Anuki16/gas-level-indicator/Product photo.jpeg

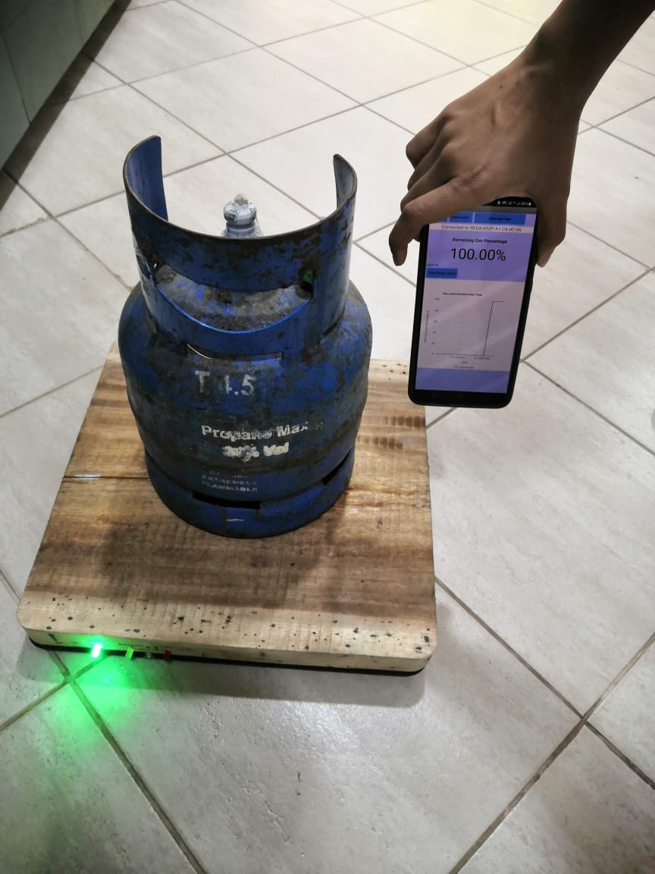
Product photo.jpeg
