Anuki16/gas-level-indicator/hx711 circuit.png

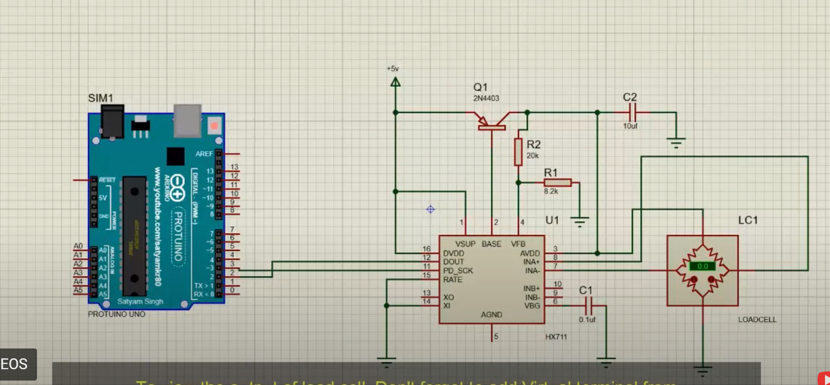
hx711 circuit.png
