Anuki16/gas-level-indicator/Design Project Presentation.pdf

# GasCheck Gas Level Indicator

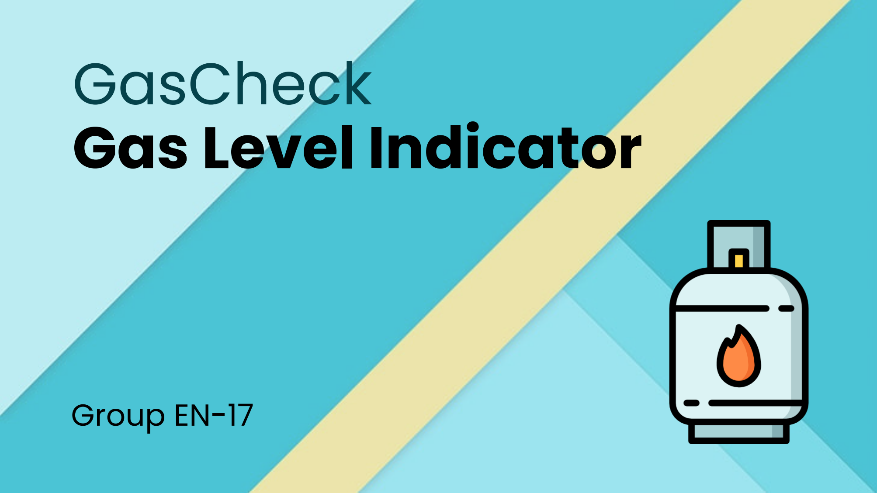
[picture p3: page 1]

## Group EN-17

In Sri Lankan households, LPG is the common fuel used for cooking.
In the prevailing economic crisis, it has become a difficulty to purchase gas in many households. Because of that, it has become a necessity to

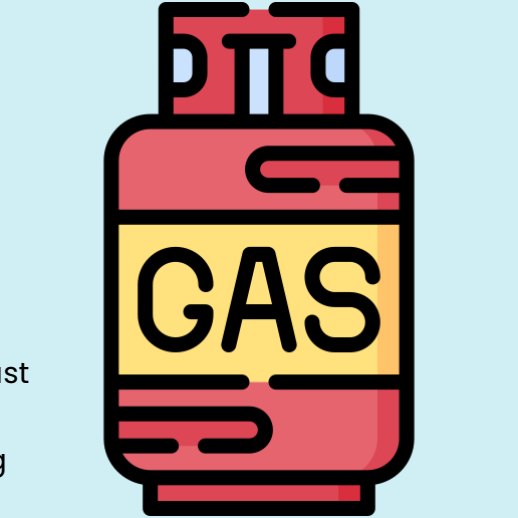
[picture p4: figure]

carefully manage the usage of gas and make it last longer.
As there is no method of measuring the remaining gas level precisely, the only current way of doing this is by guesswork.

# The Problem

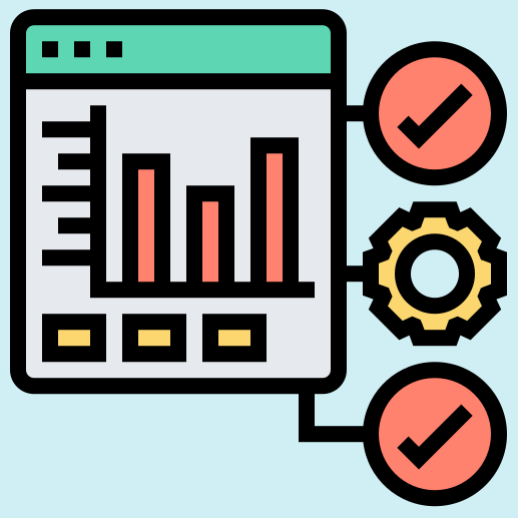
[picture p5: figure]

To help people conserve gas optimally, our idea was to design a method to measure the remaining gas level in the cylinder.

We conducted a survey to validate whether the problem we identified is worth handling and whether our solution is useful.

79 people responded and 76 were gas users.

# Problem Validation

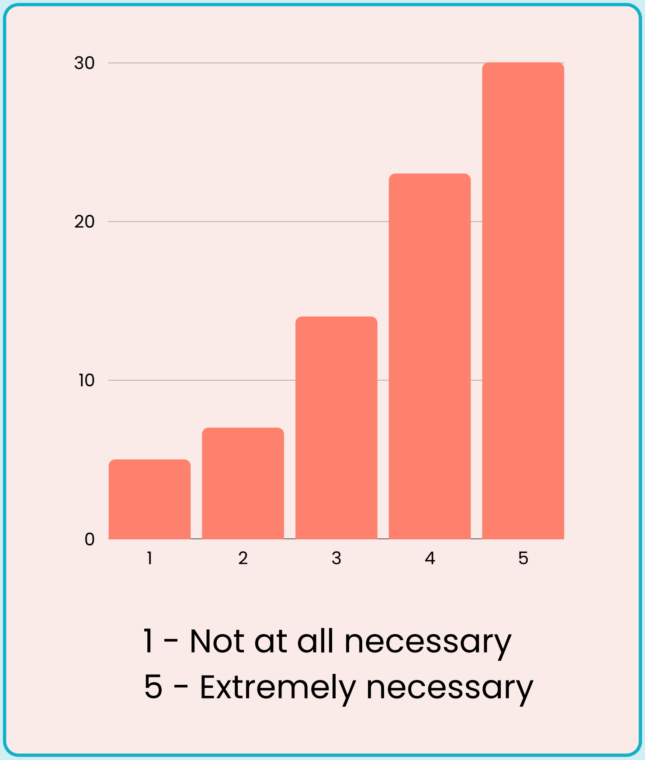
[picture p6: figure]
1 - Not at all necessary 5 - Extremely necessary

Gas conservation at home is extremely necessary for 38% of the respondents, and 84.6% considered it to be at least a moderate necessity.

# Necessity of gas conservation

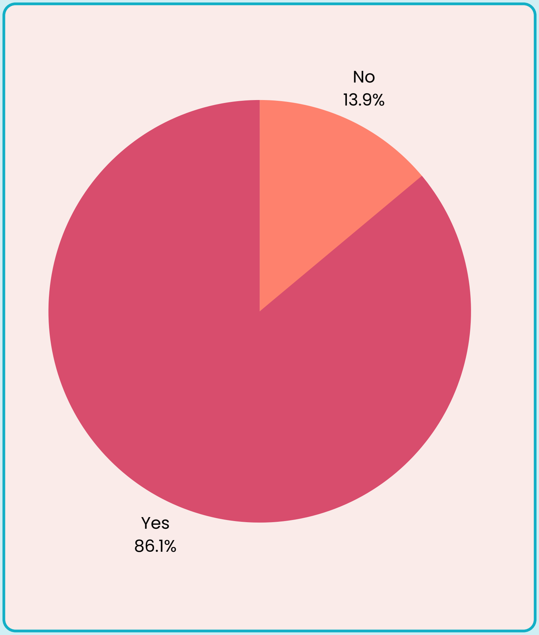
[picture p7: figure]
Yes 86.1%

86.1% of the respondents agreed that a method of checking the gas level will make it easier to conserve and manage gas usage in their households.

# Usefulness of the solution

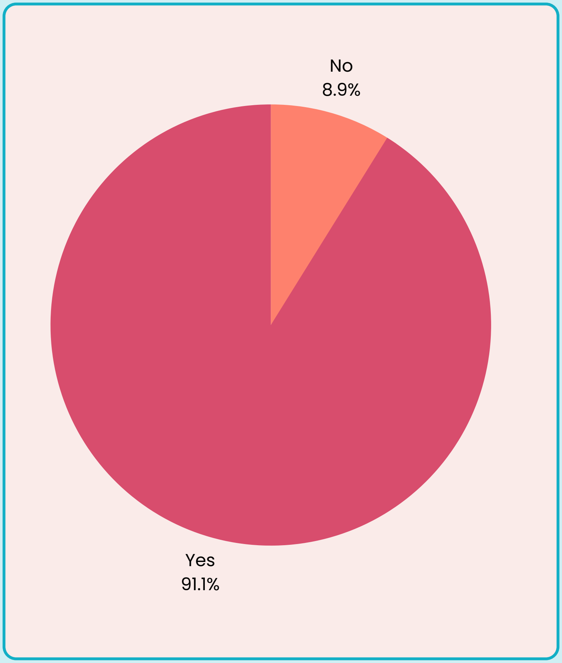
[picture p8: figure]

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
willin

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
h in

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
m in

a

n
a

p

p

e

alin

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
will b

e

b

e

n

e

ficial t

o

a
sig

nific

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
# s. Appeal of the product

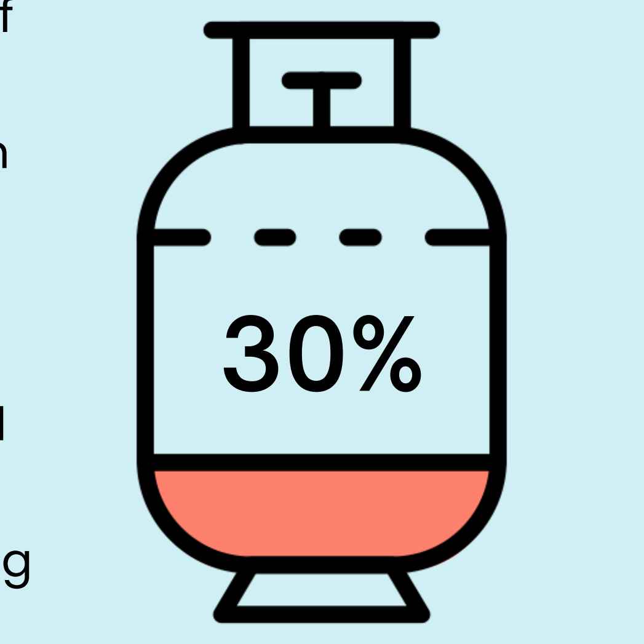
[picture p9: figure]

Consists of a weighing scale and a mobile application connected using Bluetooth
The cylinder is continuously kept on the scale
The mobile app will show the remaining gas percentage and other statistics about gas usage, and notify when the gas level is low
The scale lights up LEDs with different colors depending on the gas level
Compatible with all cylinder sizes used in households

A device which will be able to calculate the percentage of gas remaining in the cylinder by measuring its weight.

# Our product

Accuracy of gas percentage | 12.5kg : 1.6% 5kg : 4%
Power supply | 4 AA batteries
Power consumption | ~200 mW
Dimensions of the scale | 35 x 35 x 3 cm
Expected lifetime | 4 years
Warranty period | 1 year

# Technical Specifications

The measurements will be
updated in the app once per hour whenever the mobile
phone is within 10 meters of the scale.

The mobile app will be able to store data up to one year.

### Four half-bridge strain gauge load cells (50 kg capacity)

### HX711 load cell amplifier

### ATmega328P microcontroller

### HC-06 Bluetooth module

# Main Components

All these components are
commonly found at an affordable cost.

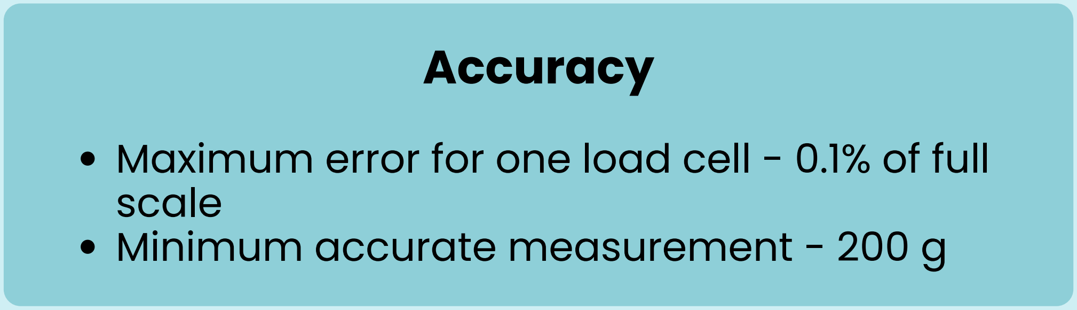
[picture p10: figure]
scale Minimum accurate measurement - 200 g; Accuracy

Maximum error for one load cell - 0.1% of full

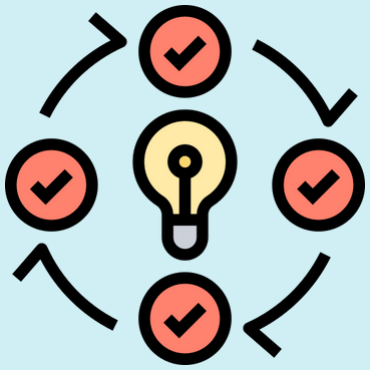
[picture p11: figure]

# Technical Feasibility

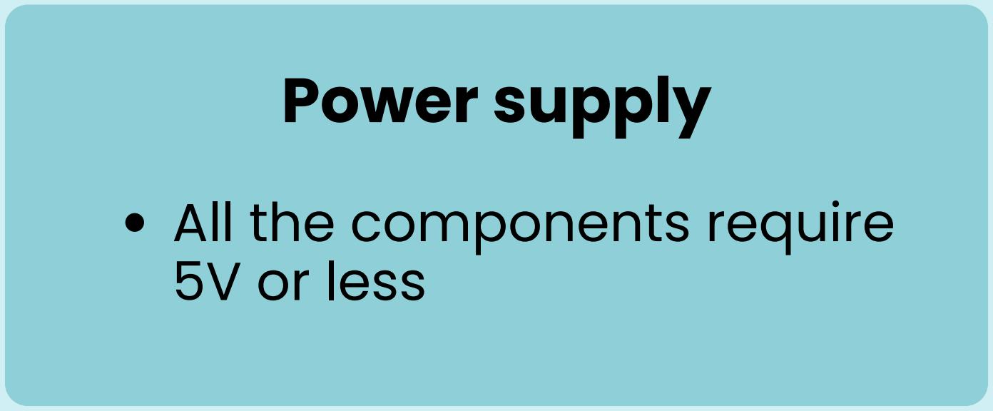
[picture p12: figure]
All the components require 5V or less; Power supply

# Technical Feasibility

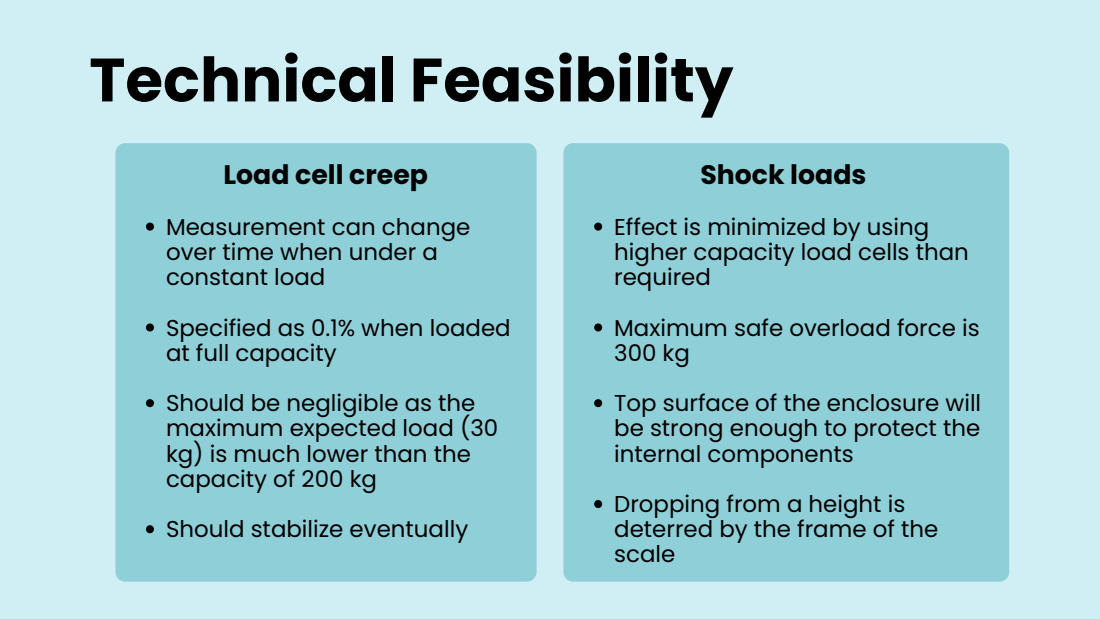
[picture p13: page 11]

Load cell creep
Measurement can change
over time when under a
constant load
Specified as 0.1% when loaded
at full capacity
Should be negligible as the
maximum expected load (30
kg) is much lower than the
capacity of 200 kg
Should stabilize eventually

Shock loads
Effect is minimized by using
higher capacity load cells than
required
Maximum safe overload force is
Top surface of the enclosure will
be strong enough to protect the
internal components
Dropping from a height is
deterred by the frame of the
scale

# Product Architecture

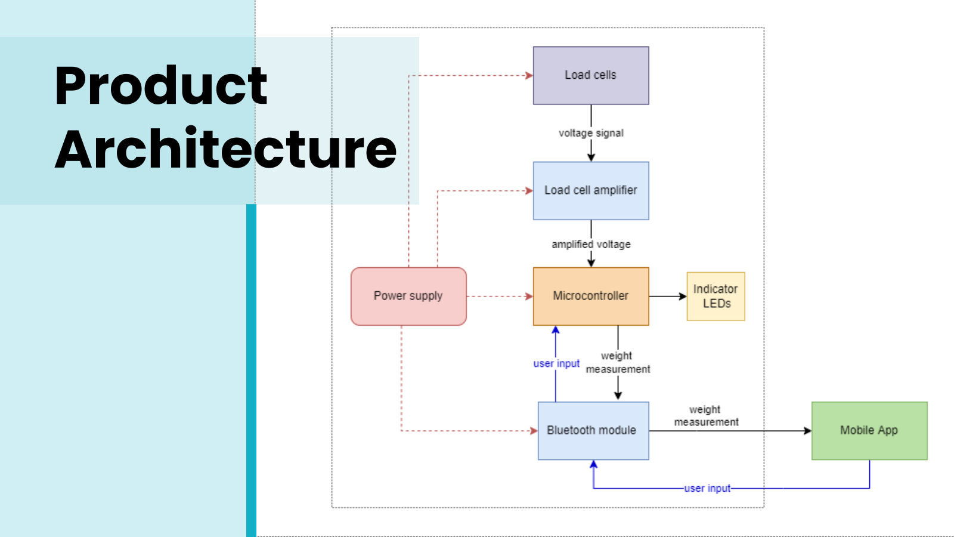
[picture p14: page 12]

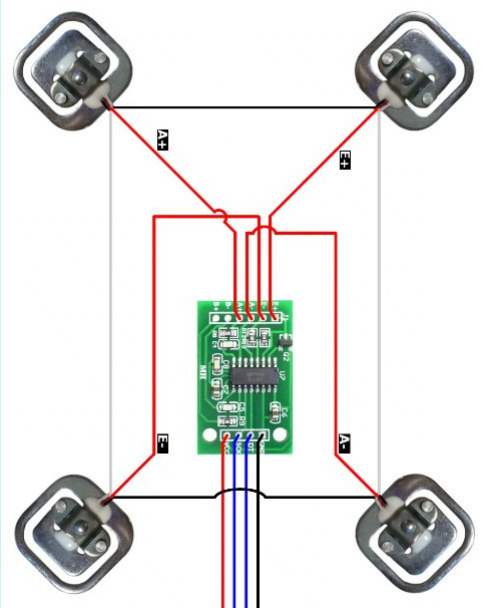
[picture p15: figure]

# Load cells

Change output voltage
proportional to the applied load Placed in the four corners and connected in a Wheatstone
bridge formation

# Load cell amplifier

Amplifies the voltage change detected from the load cells

# Microcontroller

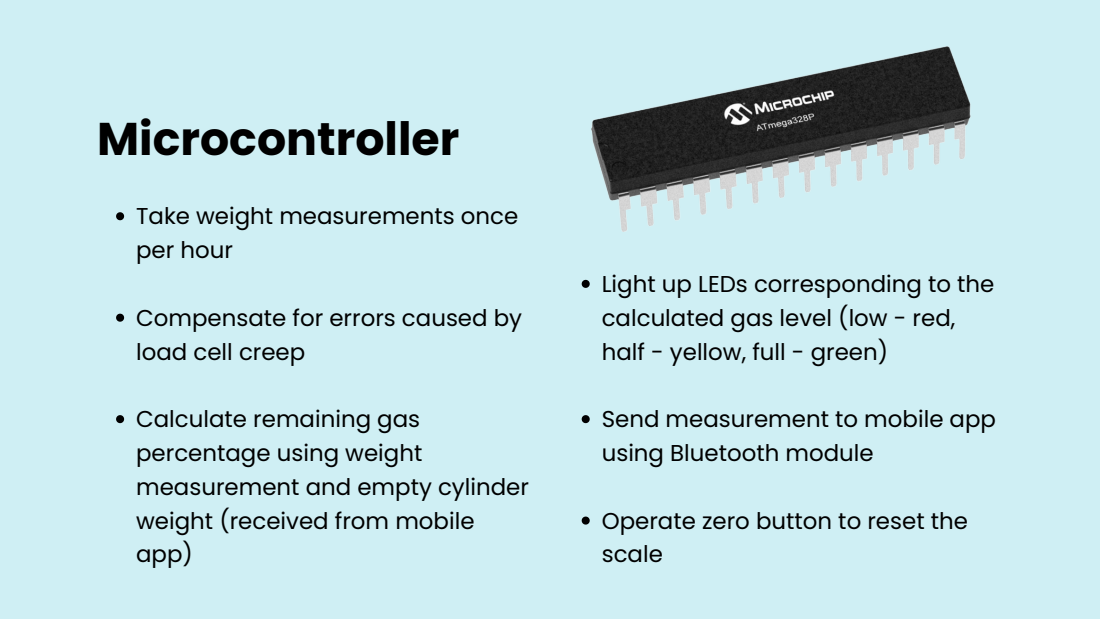
[picture p16: page 14]

Take weight measurements once
per hour

Light up LEDs corresponding to the
calculated gas level (low - red,
half - yellow, full - green)

Compensate for errors caused by
load cell creep

Calculate remaining gas
percentage using weight
measurement and empty cylinder
weight (received from mobile
app)

Send measurement to mobile app
using Bluetooth module

Operate zero button to reset the
scale

# Bluetooth Module

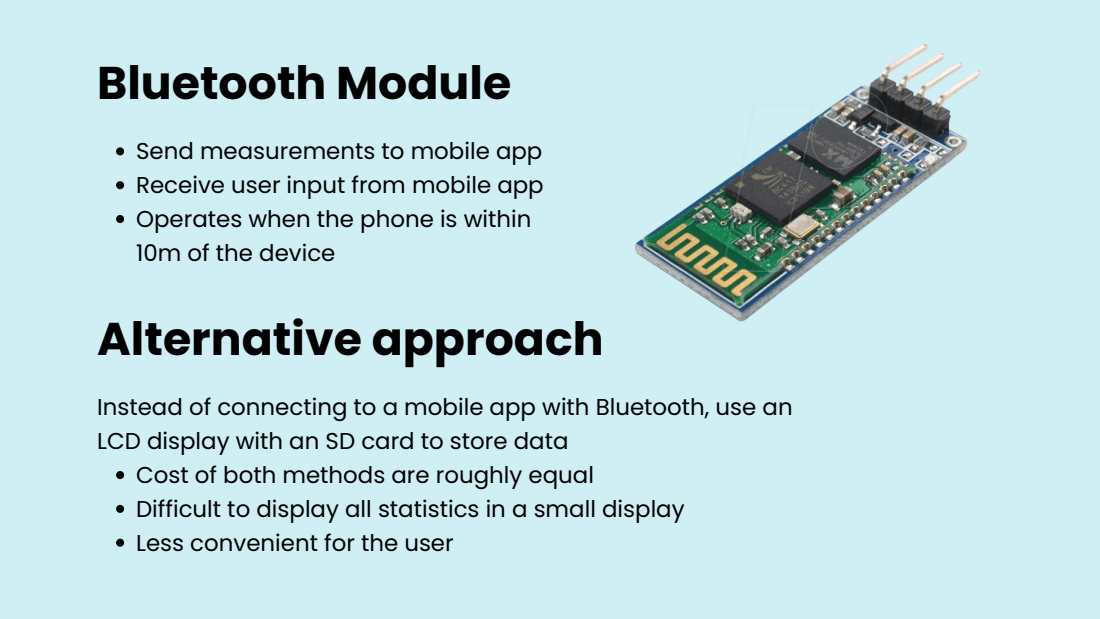
[picture p17: page 15]

Send measurements to mobile app
Receive user input from mobile app
Operates when the phone is within
10m of the device
Alternative approach

Instead of connecting to a mobile app with Bluetooth, use an
LCD display with an SD card to store data
Cost of both methods are roughly equal
Difficult to display all statistics in a small display
Less convenient for the user

# Enclosure and UI Design

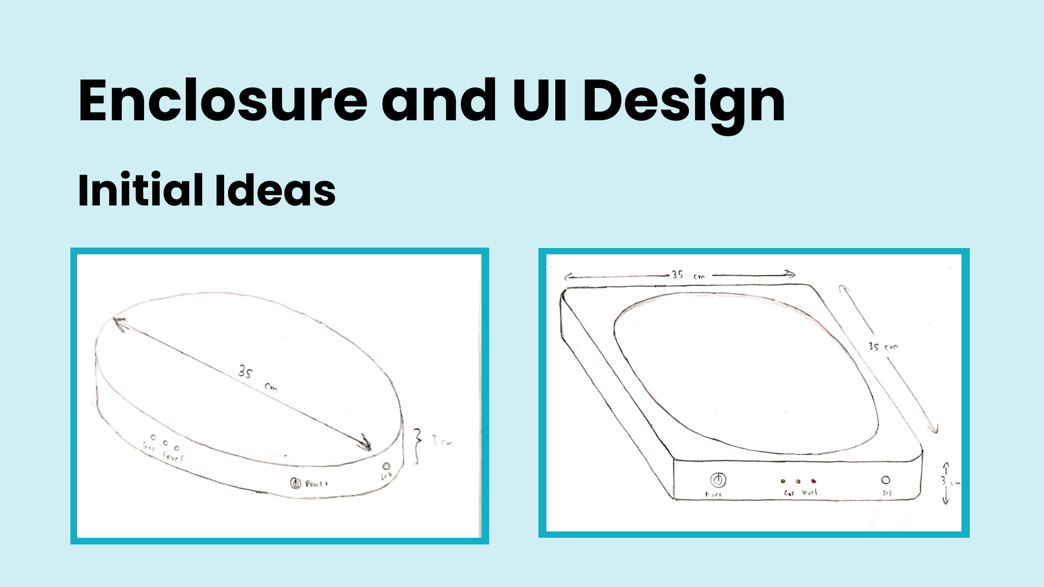
[picture p18: page 16]

# Initial Ideas

Final Sketch | Improvement

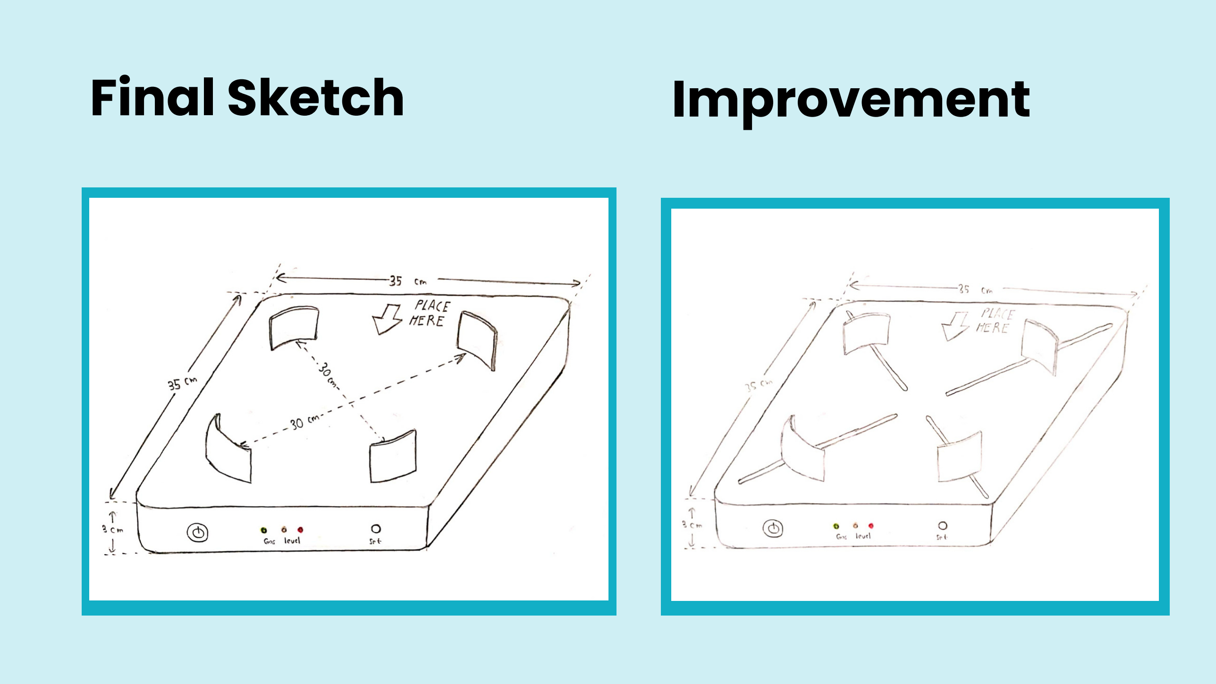
[picture p19: page 17]

# UI Design - Weighing Scale

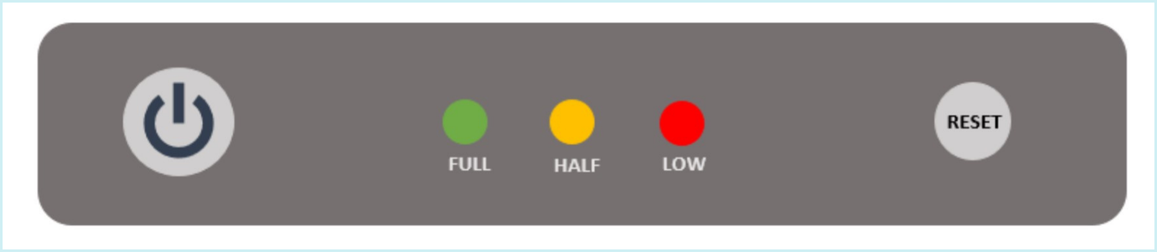
[picture p20: figure]

# UI Design - Mobile App

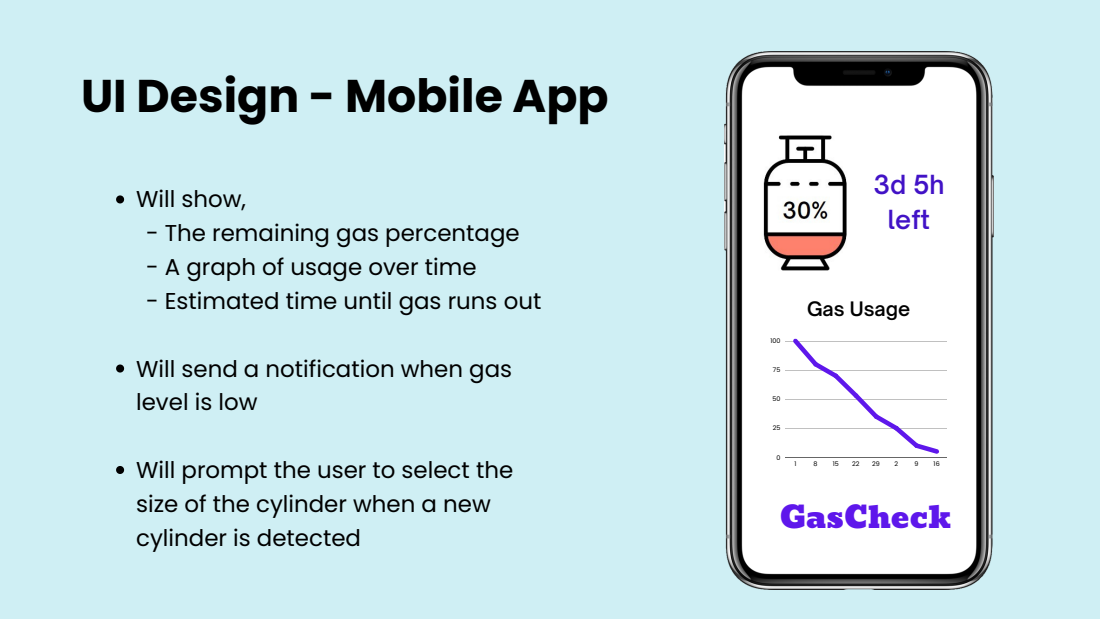
[picture p21: page 19]
3d 5h left; Gas Usage; GasCheck

Will show,
- The remaining gas percentage
- A graph of usage over time
- Estimated time until gas runs out

Will send a notification when gas
level is low

Will prompt the user to select the
size of the cylinder when a new
cylinder is detected

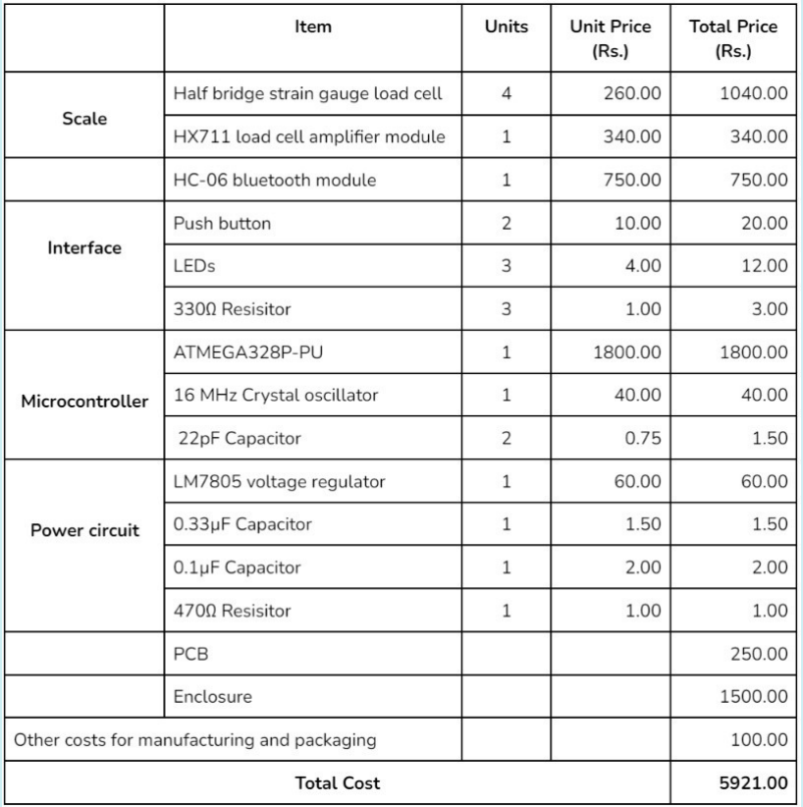
[picture p22: figure]

# Project Budget

Keeping a 10% profit
margin, the product can be sold at Rs. 6500.

The manufacturing costs
will be reduced by buying
components in bulk.

Marketing | Sales

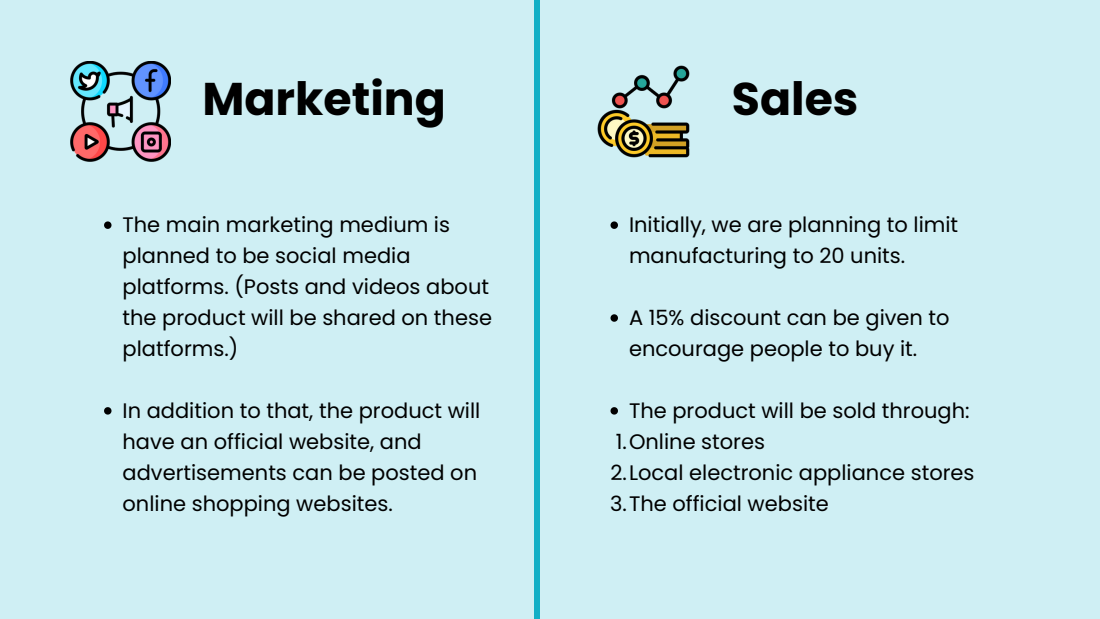
[picture p23: page 21]

The main marketing medium is
planned to be social media
platforms. (Posts and videos about
the product will be shared on these
platforms.)

Initially, we are planning to limit
manufacturing to 20 units.

A 15% discount can be given to
encourage people to buy it.

In addition to that, the product will
have an official website, and
advertisements can be posted on
online shopping websites.

The product will be sold through:
Online stores
Local electronic appliance stores
The official website

# Maintenance and Repair

# Reuse of Components

No regular maintenance, but recommended to zero the scale before placing a new cylinder

Periodic software updates will be provided for the mobile app

As only common components are used, it will be possible to repair the device from general electronic repair centers. 1 year warranty will be provided.

The load cells are likely to be the point of failure

In that case, the more expensive electronic components such as the microcontroller and Bluetooth module can be taken out and reused.

The metal parts of the enclosure can be recycled and used for other purposes.

# Thank you
