Anuki16/gas-level-indicator/EN-17 Detailed Project Proposal.pdf

## University of Moratuwa

Faculty of Engineering
Department of Electronic and Telecommunication Engineering

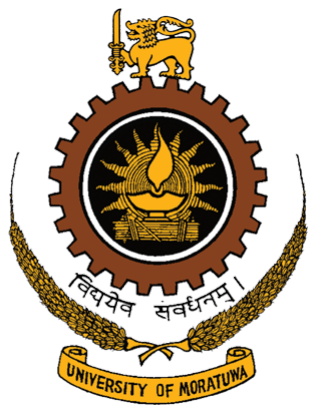
[picture p24: figure]

Detailed project proposal

### GasCheck - Gas Cylinder Level Indicator

Group EN-17

Group members:

200439G | Gunatilake P.T.B
200445V | Pasqual A.C
200449L | Pathirana K.P.T.R
200455C | Perera G.L.S.M

24

th July 2022

### Table of contents

The Problem | 3
Product Idea Validation | 4
Product Description | 6
Technical Specifications | 7
Product Architecture | 8
Load Cells | 8
Load Cell Amplifier | 9
Microcontroller | 9
Bluetooth Module | 10
Mobile App | 10
Power Supply | 11
Alternative Approaches to the Architecture | 11
Technical Feasibility | 12
Accuracy and Measurement Resolution | 12
Power Supply | 12
Power Consumption | 12
Effect of Load Cell Creep | 13
Effect of Shock Loads | 13
Hardware and Software Requirements | 14
Enclosure Design | 15
Sketches of Initial Ideas | 15
Final Sketch | 15
Material, Color and Finish | 16
User Interface Design | 17
Weighing Scale | 17
Mobile App | 17
Project Budget | 18
Marketing, Sales and Beyond | 19
Marketing | 19
Sales | 19
Product Packaging | 20
Maintenance and Repair | 20
Reuse of Components | 20
Task allocation among the group members | 21

The Problem

In Sri Lankan households, LPG (Liquefied Petroleum Gas) is one of the most common fuels used for cooking. But in the current economic crisis, purchasing gas has become a difficulty in many households. Because of that, it has become a necessity to carefully manage the usage of gas and make it last longer. However, in the normal manner of using gas cylinders, conservation can only be done by guesswork as there is no way of knowing how much gas has been used until the cylinder runs out of gas. Overcoming this limitation could be useful for many households in the country.

Another common problem that stems from the same limitation (which is relevant even without a crisis) is unexpectedly running out of gas before a new one could be purchased, causing waste of time and money.

As going by guesswork is not satisfactory, we were motivated to design a device which can detect the remaining gas level in the cylinder to a certain precision. It will benefit all people who use LPG for cooking, especially at this time when conserving gas is highly necessary.

Product Idea Validation

Because of the shortage of LPG supply in the country, people are now more focused on conserving gas as much as possible. Therefore, the lack of a way to know the gas level is a more significant problem than before.

When there is a way to know the amount of gas in the cylinder, it is possible to monitor how much gas was used for a particular task, and this will enable the user to optimally allocate gas amounts for various tasks. Also, knowing that the gas level is low will subconsciously allow the user to efficiently use the remaining amount of gas. Hence, a product that enables this will be beneficial for people to handle the above mentioned problems.

Since the product is to be aimed at the average Sri Lankan household, affordability should also be a priority consideration.

We conducted a short survey through Google Forms to confirm whether the problem we identified is actually worth handling according to the general public, and whether our solution is suitable.

- Out of the 79 responses we received, almost all (76) were from people who use gas as a cooking fuel. Gas conservation at home is extremely necessary for 38% of the respondents, and 84.6% considered it to be at least a moderate necessity.

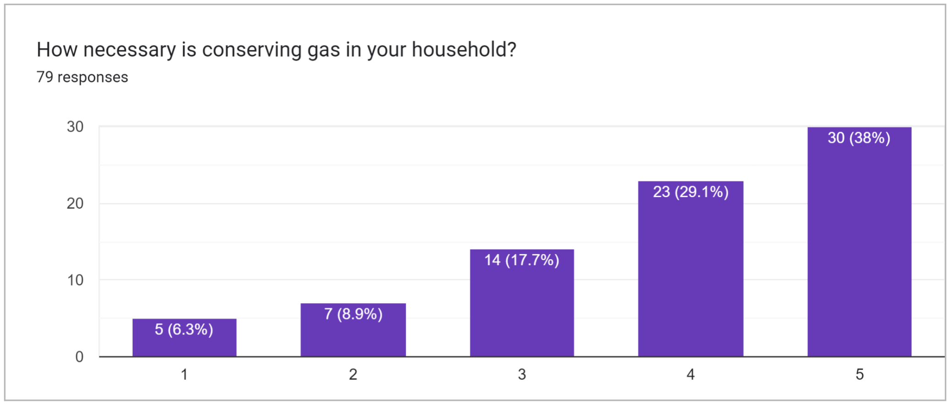
[picture p25: figure]

- 86.1% of the respondents agreed that a method of checking the gas level will make it easier to conserve and manage gas usage in their households.

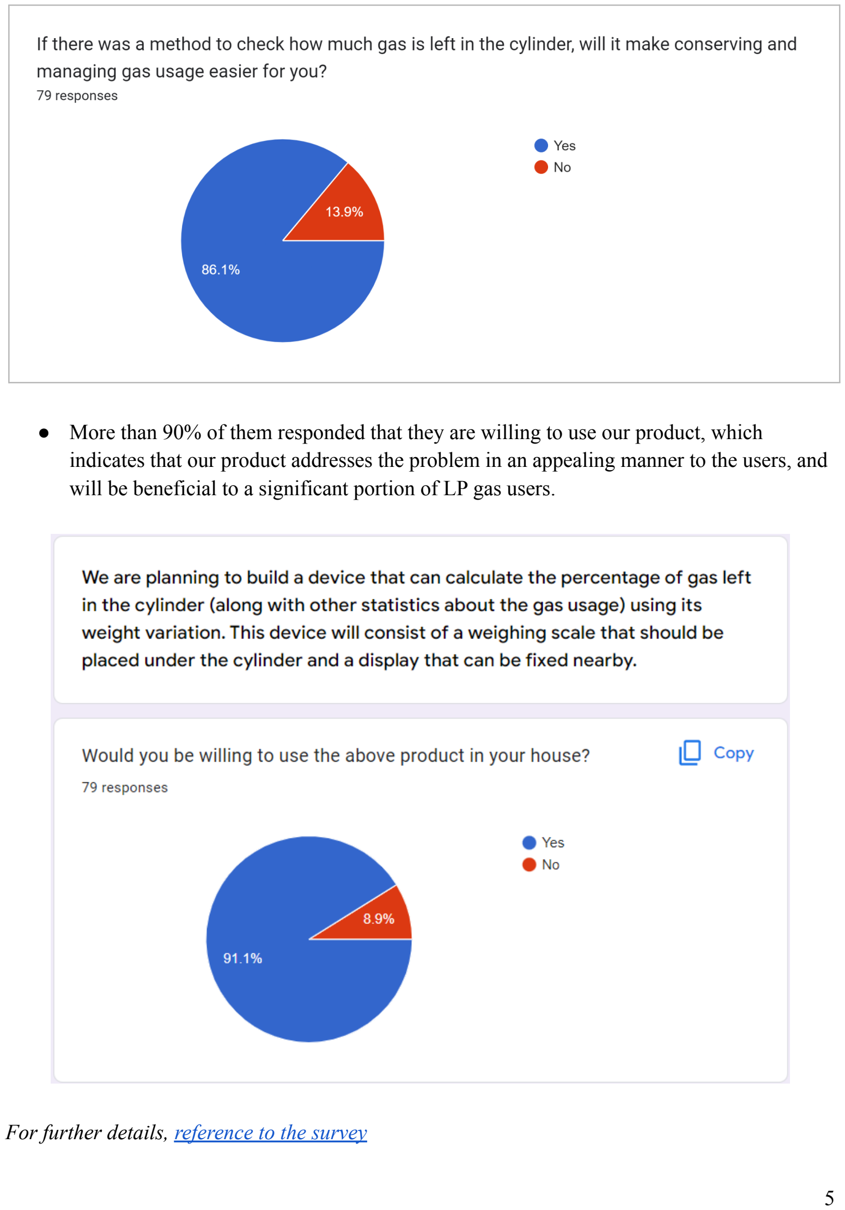
[picture p26: page 5]

- More than 90% of them responded that they are willing to use our product, which indicates that our product addresses the problem in an appealing manner to the users, and will be beneficial to a significant portion of LP gas users.

For further details, reference to the survey (https://docs.google.com/forms/d/e/1FAIpQLSf0Z_lsQsqtOtmye7ZZpWcw6FovzhU-_nx_72Yx2ZBXdHLyKg/viewanalytics)

Product Description

The product we propose to solve the above problem is a device that can calculate the amount of remaining gas in the cylinder by measuring its weight. The product will be a simple weighing scale on which the gas cylinder should be placed. It will track the weight variation of the cylinder over time and calculate the percentage of gas remaining in the cylinder, using the known or precalculated weight of an empty gas cylinder. The device will be connected to the user’s mobile phone through Bluetooth, and the information can be viewed through a mobile app.

The app will provide the following information:
- The percentage of gas remaining in the cylinder
- A graph showing the usage of gas over time, enabling the user to identify periods of high gas usage
- Other statistics about gas consumption such as the time the gas cylinder has been in use for and estimated time until gas runs out
- Notification alerts when a low gas level is detected

The product will be compatible with all sizes of gas cylinders that are commonly used in households, and the user has to select the type and the size of the gas cylinder in the app when a new one is placed.

There will also be LED lights on the scale which will change colour depending on the gas level (green - full, yellow - medium, red - low). This will let other people in the household keep track of the gas level as well, without needing access to the connected phone.

When using the product, the scale can be kept under the cylinder without using a significant amount of extra space. Once the cylinder is placed on the scale, the gas level percentage and statistics can be checked at any time without extra effort from the user until the cylinder has to be replaced.

Technical Specifications

- Accuracy of gas percentage
12.5 kg cylinder: ±1.6%
5 kg cylinder: ±4%
- Power supply: 4 x 1.5V AA batteries
- Power consumption: 182.5 mW
- Dimensions of the scale
- Height: 3 cm
- Length and width: 35 x 35 cm
- Expected lifetime: 4 years
Warranty period for product: 1 year
- The measurements will be updated in the app once per hour whenever the mobile phone is within 10 meters of the scale.
- The mobile app will be able to store data up to one year.

Product Architecture

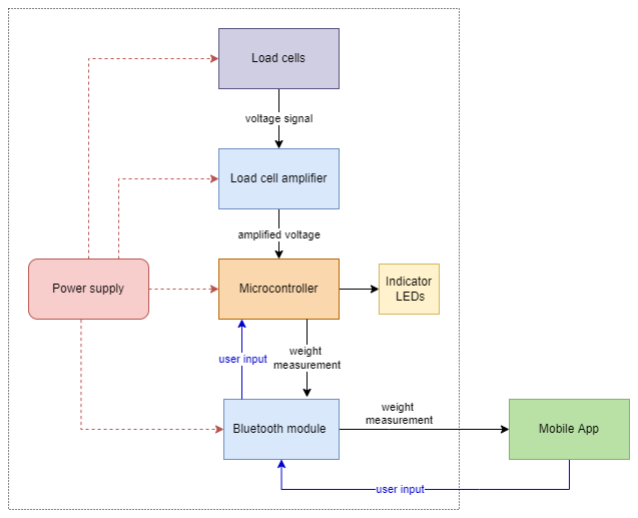
[picture p27: figure]

The functionality of each block are as follows:

Load Cells

The load cells being used are half bridge strain gauge type load sensors with 50 kg capacity each. The resistance of the strain gauges in the load cells change proportionally to the applied load. This results in a change of output voltage which can be converted into a weight measurement.

For this design, the scale will contain 4 load cells arranged symmetrically and connected in a Wheatstone bridge configuration. This setup allows us to get an output voltage proportional to the load on all 4 load cells without needing to use a voltage summing box to connect them.

Load Cell Amplifier

It is difficult to detect accurate voltage changes directly from the load cells as the change will be very small. Therefore, a load cell amplifier is used to amplify the voltage change before feeding it into the control unit. This task is done by an HX711 load cell amplifier module, which consists of an amplifier with variable gains and a 24-bit analog to digital converter.

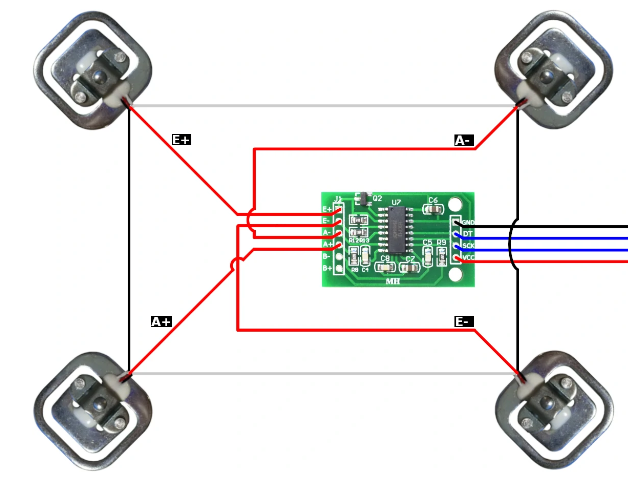
[picture p28: figure]

Load cell configuration with HX711 (source) (https://circuitjournal.com/50kg-load-cells-with-HX711)

Microcontroller

The microcontroller unit used in this design is an ATmega328P-PU microcontroller. It will perform the following tasks:

- Initially calibrates the scale, and takes weight measurements once per hour
- Since a constant load is applied on the scale for a long time, there can be small errors in the measurements due to load cell creep (explained in the technical feasibility section). The microcontroller will try to compensate for these errors and make the reading more accurate.
- It will receive the user input of the size of the cylinder from the mobile app. Using the difference between the weight measurement and the empty gas cylinder weight, the remaining gas percentage can be calculated. The weight of an empty cylinder can be provided in two ways:

1. By measuring the weight when a new cylinder is placed, then subtracting the full weight of gas within it
2. Pre-measuring the empty weight of each type of gas cylinder, since they are made in standard sizes
As method 1 will give inaccurate results if a partially filled cylinder is placed on the scale, method 2 is preferable. If the user does not provide an input, the size of the cylinder will be guessed by the software using weight measurements.
- The results will be sent to the mobile app via the Bluetooth module. When the phone is not connected to Bluetooth, the measurements will be stored in the microcontroller memory until it is possible to send them.
- It will light up LEDs corresponding to the gas level.
- Low - Red
- Medium - Yellow
- Full - Green
- It will operate the zero (tare) button to reset the scale if needed due to errors that can occur over time.

Bluetooth Module

When the phone is connected to Bluetooth, the updated measurements along with the backlog will be sent using the Bluetooth module. It will also communicate user input from the mobile app to the microcontroller. A HC-06 Bluetooth module is used for this purpose.

Mobile App

- Displays the remaining gas percentage
- Sends a notification alert when a low gas level is detected
- Stores previous data in a database and display a graph showing the gas consumption history
- Shows other statistics such as the time the cylinder has been in use for, the busiest times of each day and a rough prediction of when the cylinder will run out of gas
- Prompts the user to input the type and size of the gas cylinder when placing a new one on the scale
- The measurements will be updated every hour if the phone is within 10 m of the scale with Bluetooth turned on.

Power Supply

The device is battery powered, and will require 4 AA batteries to operate. Power will be supplied to the microcontroller and other components through a 5V voltage regulator.

Alternative Approaches to the Architecture

Instead of connecting to a mobile app using Bluetooth, a small LCD display with input buttons and a SD card module to store the data could be used.

Between the two methods, there is little to no difference in the cost. However, showing the required statistics in a user-friendly manner can be challenging unless a larger display is used, which significantly increases the cost. The additional parts will make the PCB more complex which is harder to test. Also, it is more convenient for the users if they can simply observe everything from their phone instead of going near the gas cylinder. Therefore, the approach with Bluetooth was chosen for the final design.

Technical Feasibility

Accuracy and Measurement Resolution

According to the specifications of the load cells to be used, the smallest weight change that can be accurately measured is 0.1% of full scale, which is 0.05 kg for one load cell. As the total weight will be distributed among 4 load cells, the smallest accurate measurement for the scale is 0.2 kg. This will provide the percentage of remaining gas at the following resolutions for each size of gas cylinder:
- 12.5 kg: 1.6% (62.5 levels between 0 and 100)
- 5 kg: 4% (25 levels between 0 and 100)
- 2.3 kg: 8.7% (11.5 levels between 0 and 100)

For all cylinder sizes, the above levels of accuracy are sufficient to get a rough measurement of the gas level and to accurately detect a low level of gas. With 5 kg and 12.5 kg cylinders (which are the most commonly used sizes in households), the gas percentage will be more accurately tracked.

As the HX711 module contains a 24-bit ADC, the measurements and the displayed percentages can have a higher resolution than 0.2kg even though the accuracy may not reach the same level.

Power Supply

The operating voltage ranges of the main components in the design are as follows:
- Load sensors: 2.6 - 5.5 V
- Load cell amplifier module: 2.7 - 5 V
- Bluetooth module: 3.3 - 5 V
- Microcontroller: 3.3 - 5 V
Therefore, a power supply with 4 AA batteries (1.5 V) is sufficient for the device to operate.

Power Consumption

The estimated power consumption of each main component are as follows:
- Load sensors: 25mW x 4 = 100mW
- Load cell amplifier: 7.5mW
- Bluetooth module: 40mW
- Microcontroller: 25mW
- LEDs and other components: 20mW

Total power consumption of the product is 182.5 mW.

As the main components only need to stay active once per hour, it is possible to significantly reduce this power consumption by adding sleep cycles.

Effect of Load Cell Creep

Load cell creep is the change that happens in the load cell output while under a load with no other environmental changes. This is an issue that needs to be considered in this application as the load will remain on the scale for a long time.

For the load sensors being used in this device, creep is specified as 0.1% of full scale. This is the amount of creep that can occur when the cells are loaded near full capacity. However, the maximum expected weight on this scale is around 30 kg (total weight of a 12.5 kg cylinder) which is significantly lower than the rated capacity of 200 kg. Therefore, under normal operation the creep should become negligible. Even if a larger creep occurs, theoretically the output should stabilize over time which will eventually provide accurate readings, and there are methods to compensate for creep if it becomes necessary.

For maximum accuracy, the users will be recommended to tare (zero) the scale whenever the cylinder is taken off as this can also reduce the effects of creep.

Effect of Shock Loads

As gas cylinders are usually roughly handled, there is a possibility of it being dropped from a 2-3 inch height when placing it on the scale. This causes a shock overload that may damage the load cells. Therefore, steps must be taken to handle this overload force.

The load sensors being used here have a safe overload capacity 150% of full scale, which is 75 kg. As a weight applied on the scale is equally distributed among the 4 load cells, the system is capable of handling an overload force of up to 300 kg. This can protect the scale from a 30 kg gas cylinder being dropped from a maximum height of 4 cm.

The framing of the weighing platform intended to center the weight (described in the enclosure section) will also act as a natural deterrent against dropping the cylinder from a larger height.

Hardware and Software Requirements

- All the components used in this product are commonly available in the market at an affordable price.
- As the measurements are taken hourly, only a small amount of storage space is necessary for the mobile app (8760 data values for one year). The calculations and statistical analyses do not require special processing power.

Note: The load cell specifications used for feasibility calculations were taken from a seller’s website (https://a.co/d/5yoCstb) as a standard datasheet was not available.

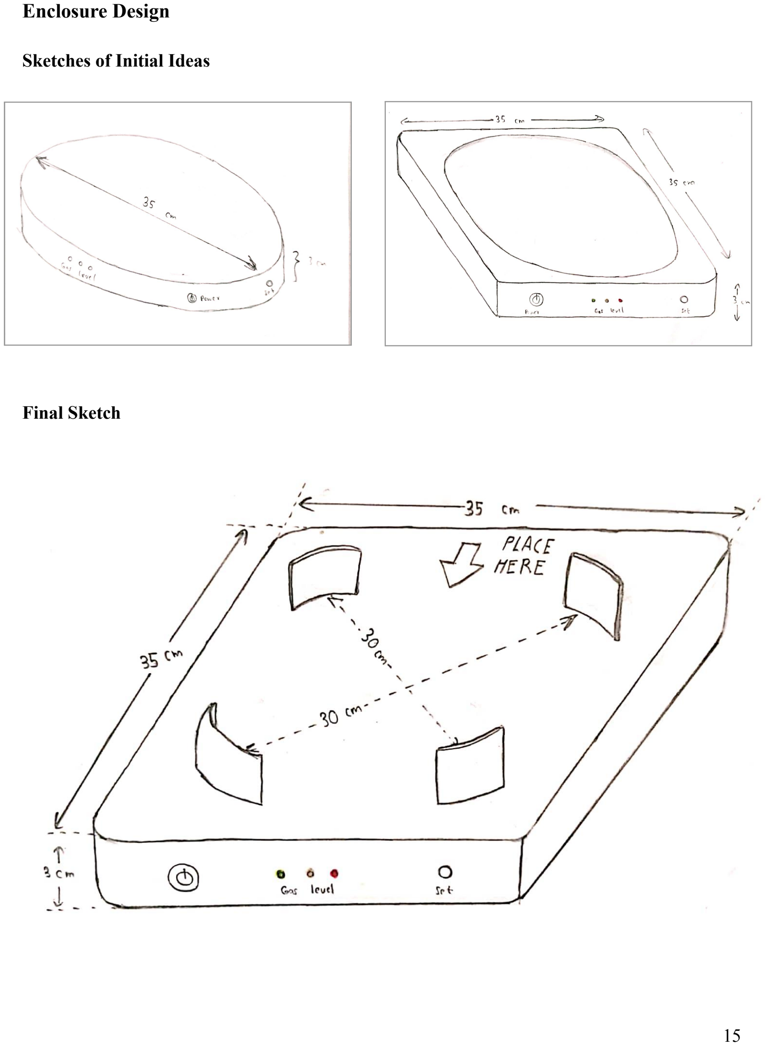
[picture p29: page 15]

Enclosure Design

Sketches of Initial Ideas

Final Sketch

- The cylinder has to be placed within the four corner frames.
- The frames will ensure that the weight of the cylinder is evenly distributed between the four load cells, and will prevent it from accidentally shifting out of place. It will also deter the user from dropping the cylinder from a height onto the scale.
- In this design, the frame will only fully serve its purpose for 12.5 kg and 5 kg cylinder sizes. However, the device will still work properly with a small 2.3 kg cylinder when it is placed in the middle of the scale.
- A further improvement to the design would be to make the frames adjustable along railings to fit smaller diameter cylinders as shown below.

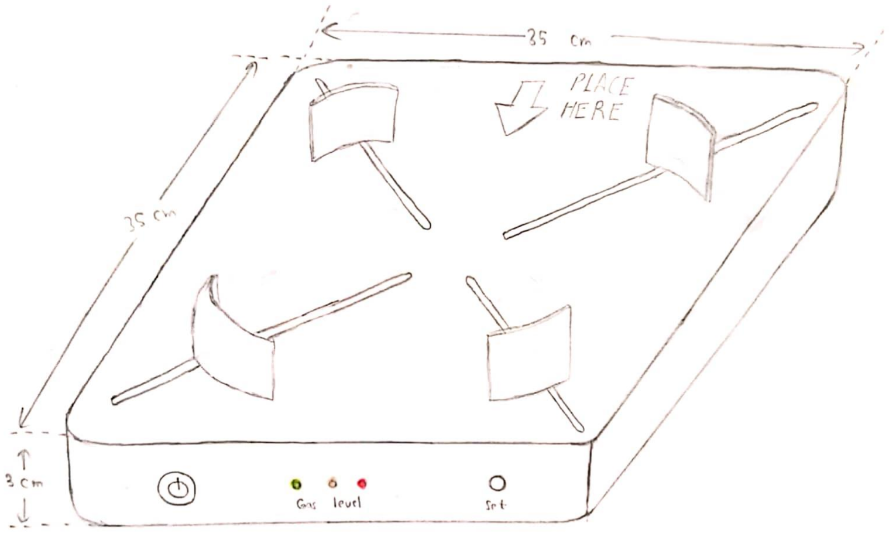
[picture p30: figure]

Material, Color and Finish

The building material should have the following qualities:
- Low cost, to be able to deliver the product at an affordable price
- Not bendable (bending might affect the accuracy of weight measurements)
- Light, compared to a gas cylinder
- Strong enough to withstand a sudden impact

We chose aluminum metal for the enclosure as it fits the above requirements. For the prototype, the enclosure can be built by CNC machining aluminum or wood.

The color and finish of the scale will also be metallic as it can be perceived as durable and well built.

User Interface Design

Weighing Scale

Since all detailed inputs and outputs are given in the mobile app, the user interface of the scale itself is minimal.

There are two input buttons on the scale:
- Power button - to turn the scale on and off
This button is made larger with a common icon so that it can be easily identified.
- Reset button - to re-zero the scale
The function of this button and when to use it will be described in the user manual.

The current level of gas will be indicated by lighting up one of the above shown LEDs. The color scheme used is intuitive for the user, and can be confirmed by the text if unsure. The red LED will stand out more and indicate urgency when the gas level is low.

Mobile App

- The gas percentage, graphs and other statistics will be clearly displayed in the mobile app as a data dashboard.
- When it is detected that a new cylinder was placed on the scale, the app will send a notification prompting the user to select the brand and size of the gas cylinder from a dropdown menu. To make it more convenient, the software will guess the correct size from the measurements taken and show that as the default option.
- The app will send a notification when a low gas level is detected, so that the user will be informed even if they do not open the app.
- The measurements will only be updated if Bluetooth is turned on. If the user opens the app without turning it on, a message will appear prompting them to do so.

Project Budget

| Item | Units | Unit Price (Rs.) | Total Price (Rs.)
Scale | Half bridge strain gauge load cell | 4 | 260.00 | 1040.00
| HX711 load cell amplifier module | 1 | 340.00 | 340.00
| HC-06 bluetooth module | 1 | 750.00 | 750.00
Interface | Push button | 2 | 10.00 | 20.00
| LEDs | 3 | 4.00 | 12.00
| 330Ω Resisitor | 3 | 1.00 | 3.00
Microcontroller | ATMEGA328P-PU | 1 | 1800.00 | 1800.00
| 16 MHz Crystal oscillator | 1 | 40.00 | 40.00
| 22pF Capacitor | 2 | 0.75 | 1.50
Power circuit | LM7805 voltage regulator | 1 | 60.00 | 60.00
| 0.33µF Capacitor | 1 | 1.50 | 1.50
| 0.1µF Capacitor | 1 | 2.00 | 2.00
| 470Ω Resisitor | 1 | 1.00 | 1.00
| PCB | | | 250.00
| Enclosure | | | 1500.00
Other costs for manufacturing and packaging | | | | 100.00
Total Cost | | | | 5921.00
- Keeping a 10% profit margin, the product can be sold at Rs. 6500. Since it can be used for a long time, this price can be considered as affordable.
- The manufacturing costs will be reduced by buying components in bulk and using cheaper bulk manufacturing methods for the enclosure. This could allow us to reduce the product price to around Rs. 5000.

Marketing, Sales and Beyond

Marketing

The main marketing medium is planned to be social media platforms such as Facebook, Youtube, Instagram, Whatsapp, etc. Posts and videos about the product will be shared on these platforms.

The following points could be highlighted in the posts to showcase the usefulness of the product:
- The problem of gas availability in the country
- The inconvenience of not knowing the remaining gas amount
- That the device requires minimal effort from the user to use
- The use of smart technology to make it convenient for the user to monitor the gas usage at any time

Introduction videos about the device can also be made explaining the following:
- Ease of use and the convenience
- The positive effects on gas conservation seen after using the device in a household
- The accuracy and reliability of the device

Although there are existing products similar to this gas level indicator, they are not readily available to buy in Sri Lanka and are much more expensive. Therefore, comparison with those products is not useful as a marketing strategy.

In addition to social media marketing, the product will have an official website, and advertisements can be posted on online shopping websites such as Aliexpress, Daraz, eBay, etc.

Sales

Initially, we are planning to limit manufacturing to 20 units and observe how the product is perceived by the general public. A 15% discount can be given to encourage people to buy it.

The product will be sold in the following ways in order to reach a larger customer base:
- Through online stores such as Daraz, eBay, Aliexpress
- Through local electronic appliance stores
- Through the official website

Product Packaging

As the enclosure will be built to withstand rough handling, a normal cardboard packaging box with bubble wrap will be sufficient for this product.

The outside of the box will show:
- Product name and a short description (GasCheck - gas cylinder level indicator)
- Images showing the intended use of the product
- That it uses a mobile app and Bluetooth connectivity

The product will come with a user manual that gives instructions on how to pair the device with Bluetooth, how to use the mobile app and the function of buttons and LEDs.

Maintenance and Repair

- No regular maintenance is required for the proper operation of the device.
- The user is recommended to zero the scale before placing a new cylinder to reduce errors caused by load cell creep and other environmental factors.
- The zero button can also be used if the scale starts giving wrong measurements due to some issue.
- Periodic software updates will be provided for the mobile app.
- As only common components are used, it will be possible to repair the device from general electronic repair centers in addition to our own representatives. 1 year warranty will be provided.

Reuse of Components

- The load cells are likely to be the point of failure in a device like this, as they are subjected to continuous strain. In that case, the more expensive electronic components such as the microcontroller and Bluetooth module can be taken out and reused.
- The metal parts of the enclosure can be recycled and used for other purposes.

Task allocation among the group members

Gunatilake P.T.B. | ● Initial and final sketches of enclosure ● Scale assembly (circuit and other hardware) ● Enclosure design
Pasqual A.C. | ● Product architecture and feasibility analysis ● Microcontroller programming for the scale ● Mobile app development
Pathirana K.P.T.R. | ● Product architecture and feasibility analysis ● Scale assembly (circuit and other hardware) ● PCB design
Perera G.L.S.M. | ● Marketing, sales and product life cycle analysis ● Testing scale operations ● Interfacing with Bluetooth
