Anuki16/gas-level-indicator/Scale UI.pptx

## Slide 2

FULL

LOW

HALF

RESET

## Slide 3

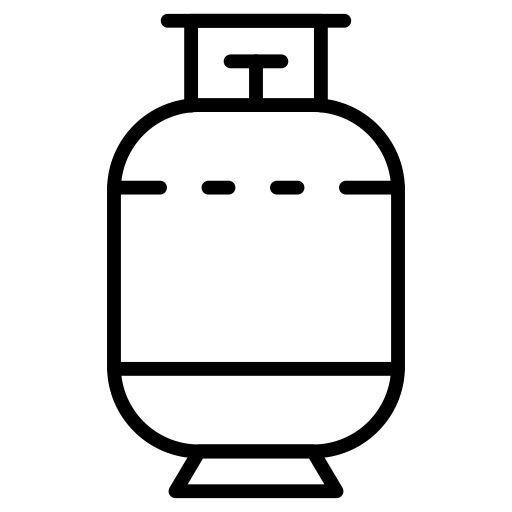
[picture p32: figure]
