Anuki16/gas-level-indicator/App images/fullgas.png

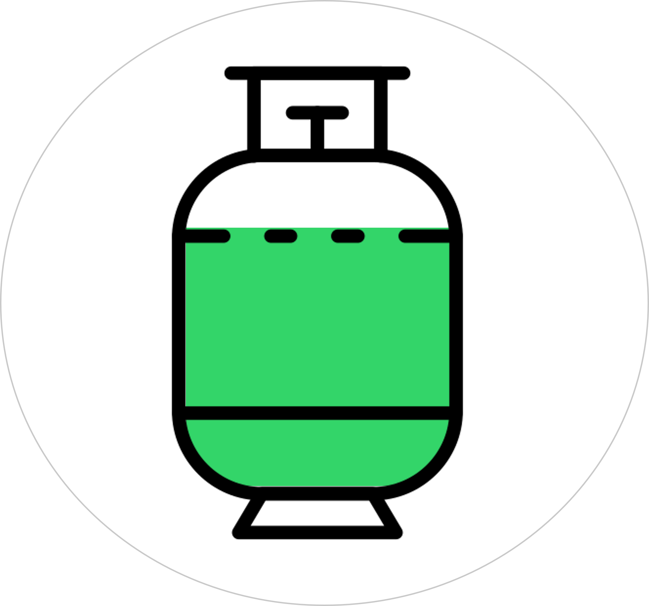
App images/fullgas.png
