Anuki16/gas-level-indicator/App images/low gas.png

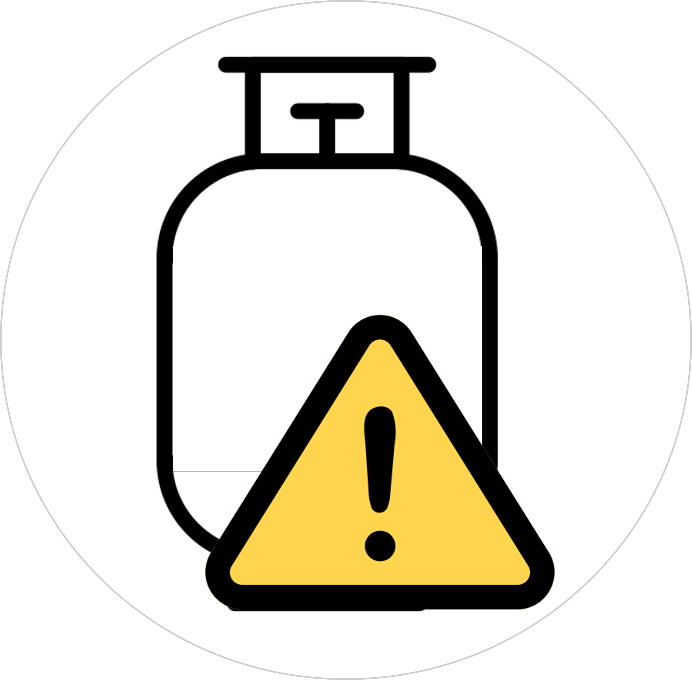
App images/low gas.png
