Anuki16/gas-level-indicator/Enclosure sketches/final.jpg

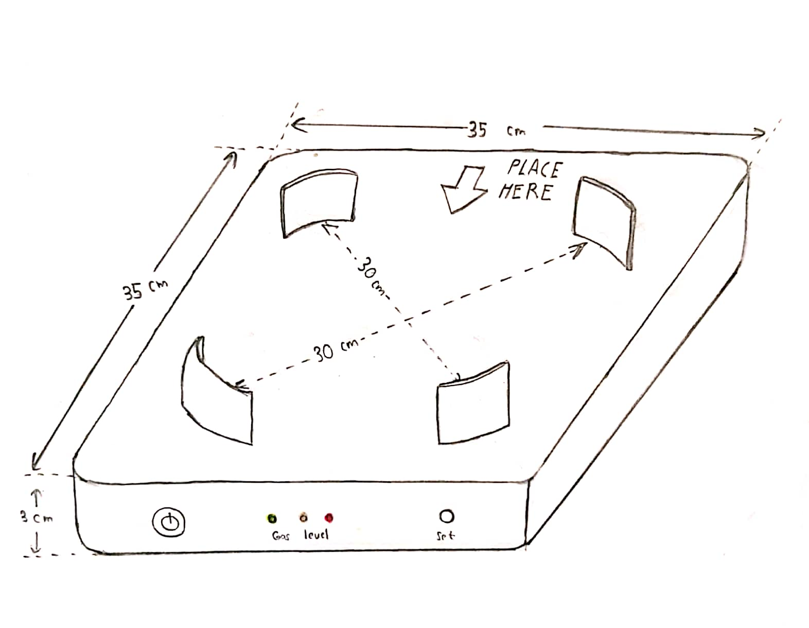
Enclosure sketches/final.jpg
