Anuki16/gas-level-indicator/Enclosure sketches/round.jpg

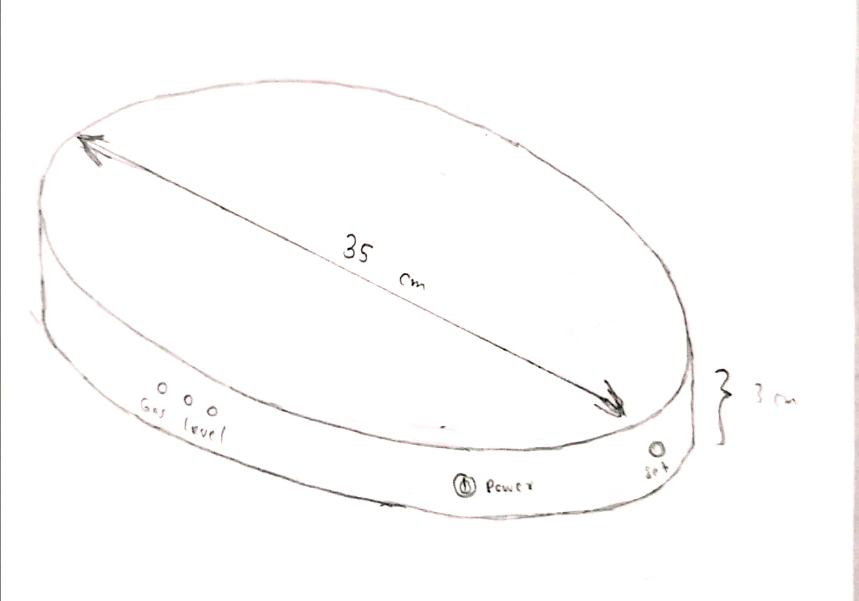
Enclosure sketches/round.jpg
