Anuki16/gas-level-indicator/Enclosure sketches/with cut.jpg

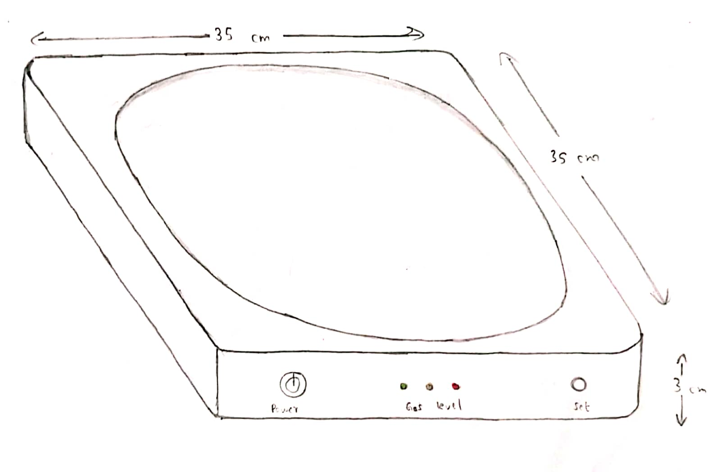
Enclosure sketches/with cut.jpg
