Anuki16/gas-level-indicator/Enclosure sketches/with rails.jpg

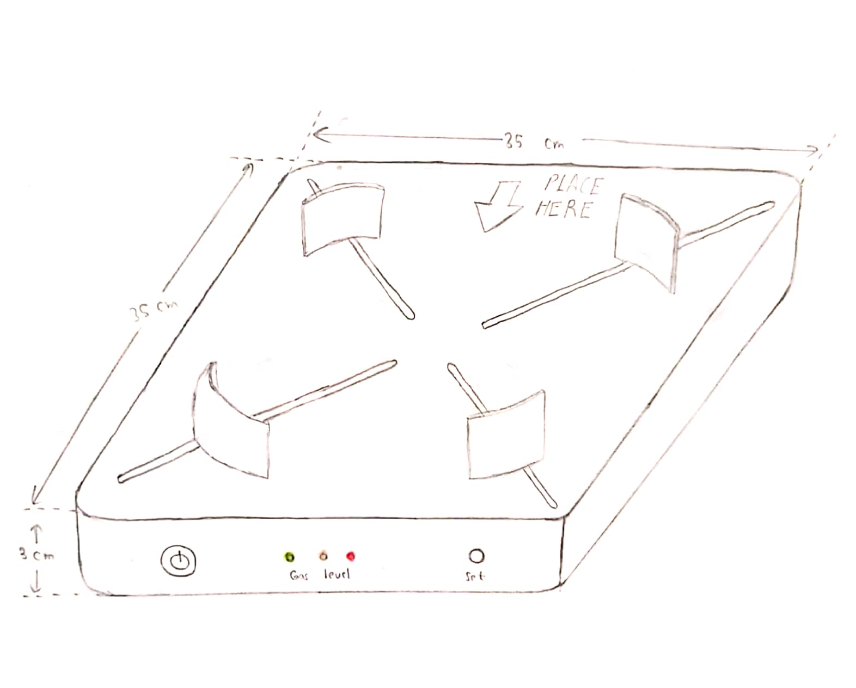
Enclosure sketches/with rails.jpg
