Anuki16/gas-level-indicator/PCB design/Schematic.jpg

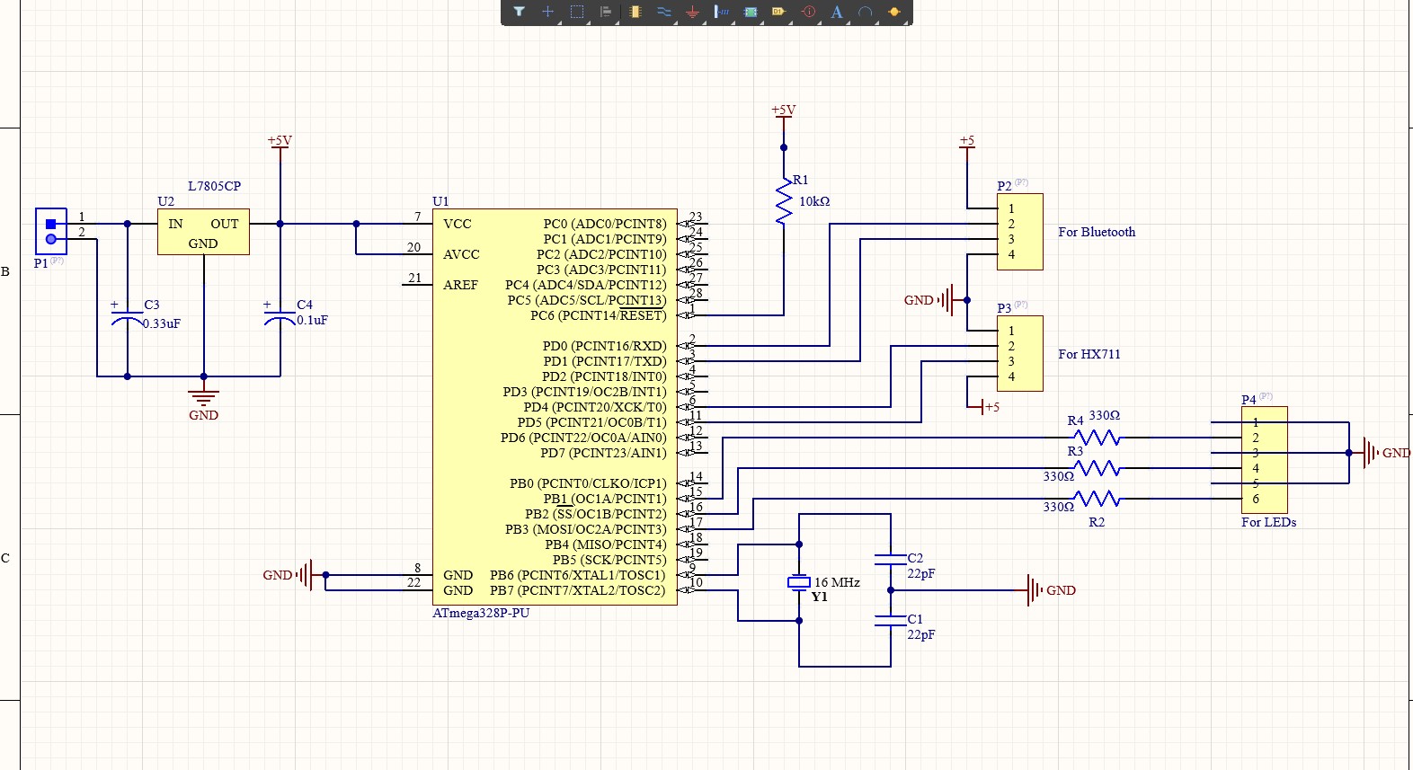
PCB design/Schematic.jpg
