Anuki16/gas-level-indicator/Presentation images/ATmega328P-M3X-Regular-removebg-preview.png

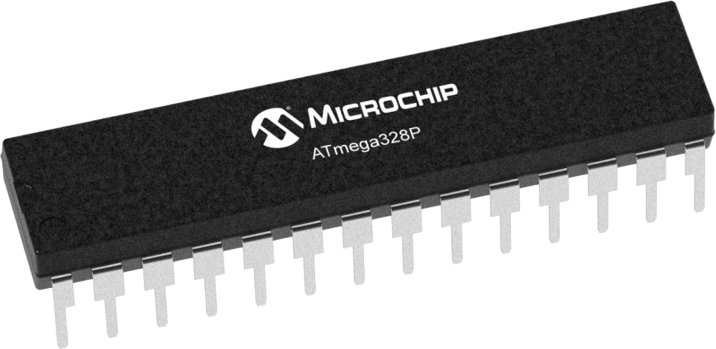
Presentation images/ATmega328P-M3X-Regular-removebg-preview.png
