Anuki16/gas-level-indicator/Presentation images/budget.jpg

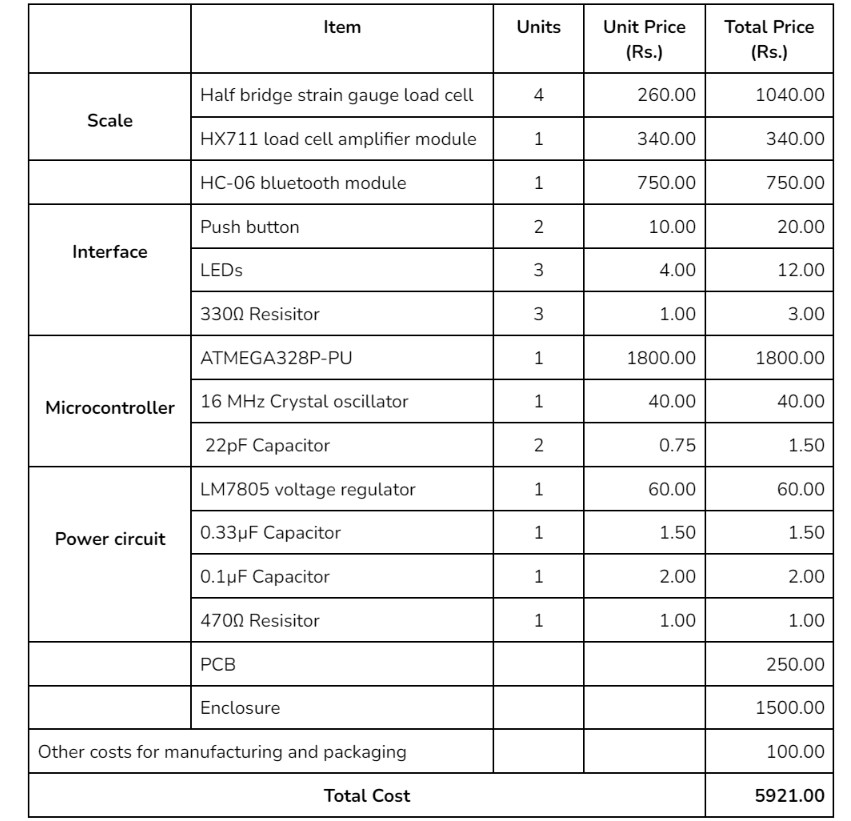
Presentation images/budget.jpg
