Anuki16/gas-level-indicator/Presentation images/feasible.png

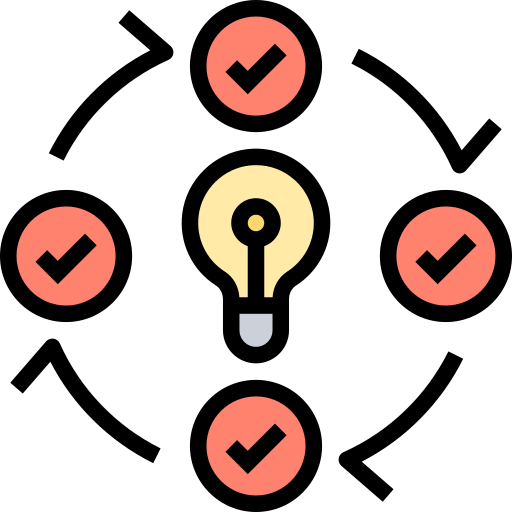
Presentation images/feasible.png
