Anuki16/gas-level-indicator/Presentation images/HC-06.png

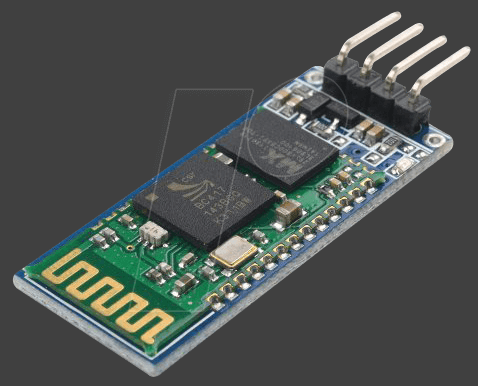
Presentation images/HC-06.png
