Anuki16/gas-level-indicator/Presentation images/remaining gas.jpg

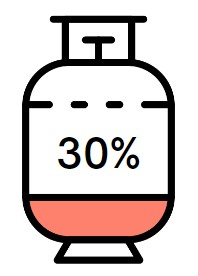
Presentation images/remaining gas.jpg
