Anuki16/gas-level-indicator/Presentation images/reuse.png

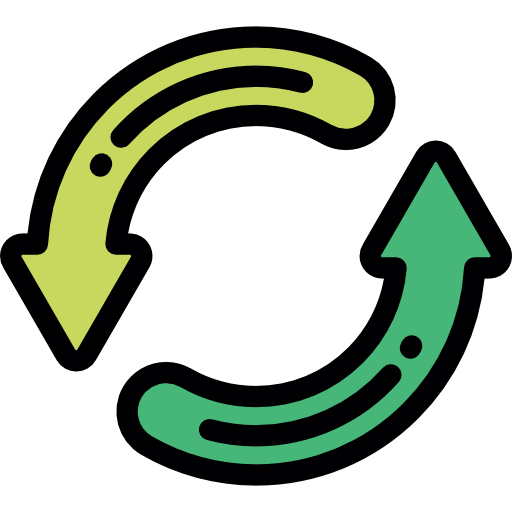
Presentation images/reuse.png
