Anuki16/gas-level-indicator/Presentation images/sales.png

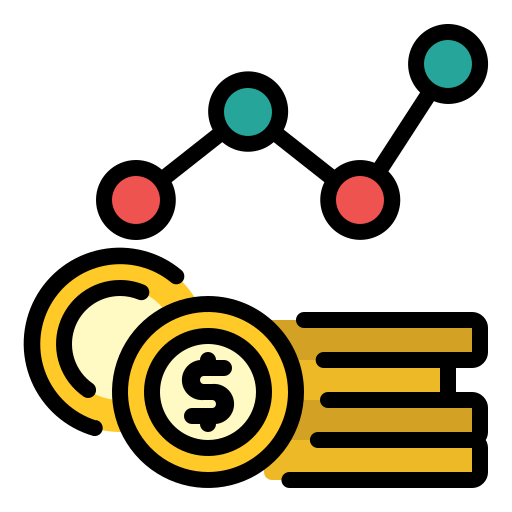
Presentation images/sales.png
