Anuki16/gas-level-indicator/Product architecture.png

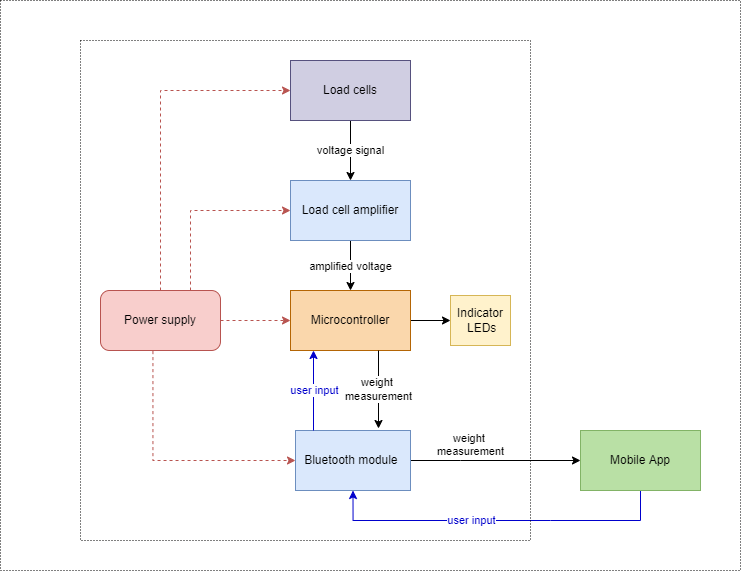
Product architecture.png
