Anuki16/gas-level-indicator/EN-17 Gas Cylinder Level Indicator/Solidworks/full_enclosure.SLDPRT

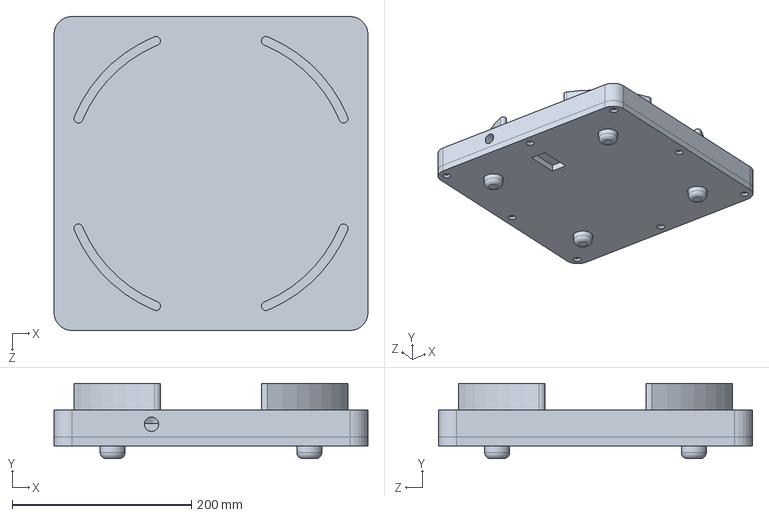
[picture p48: CAD file, 2023-03-15]
EN-17 Gas Cylinder Level Indicator/Solidworks/full_enclosure.SLDPRT
350.0 x 84.0 x 350.0 mm
