Anuki16/gas-level-indicator/EN-17 Gas Cylinder Level Indicator/Solidworks/top.SLDPRT

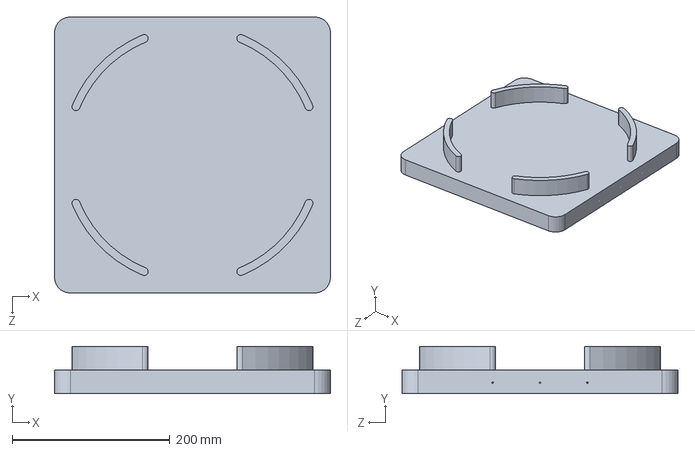
[picture p49: CAD file, 2023-03-15]
EN-17 Gas Cylinder Level Indicator/Solidworks/top.SLDPRT
350.0 x 60.0 x 350.0 mm
