Anuki16/gas-level-indicator/loadCellBracket.stl

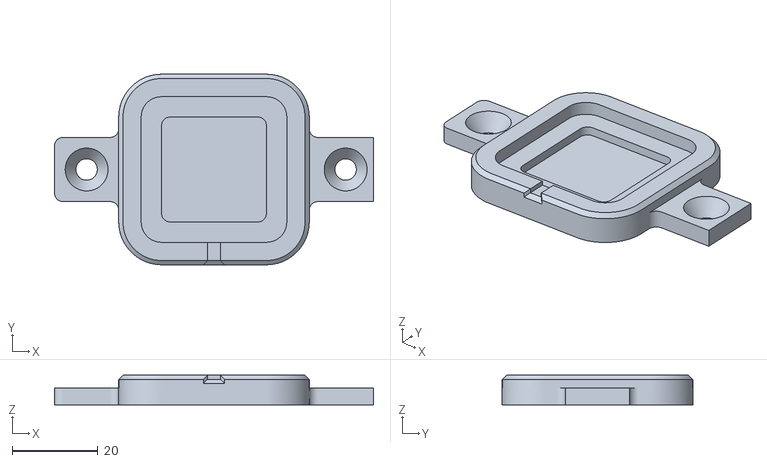
[picture p50: CAD file, 2023-03-15]
loadCellBracket.stl
74.5 x 44.5 x 7.00
