Anuki16/gas-level-indicator/ORC-KIT_9V_Battery_Holder.stl

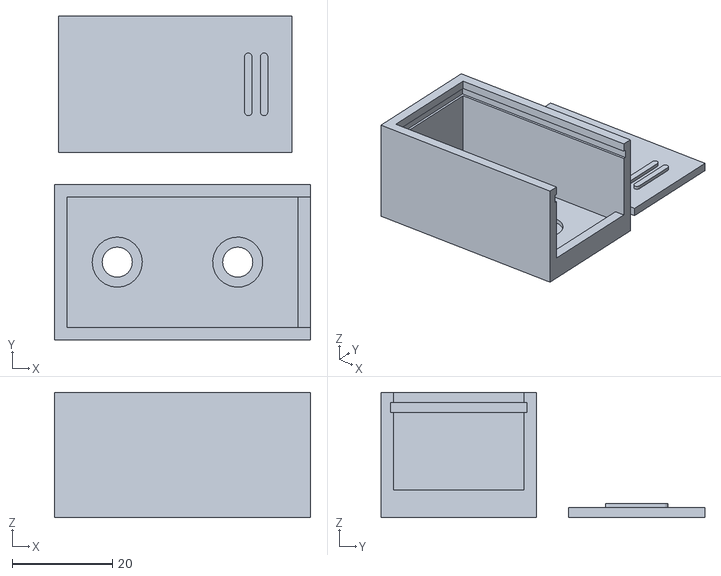
[picture p51: CAD file, 2023-03-15]
ORC-KIT_9V_Battery_Holder.stl
51.0 x 64.5 x 25.0
