Anuki16/gas-level-indicator/EN-17 Gas Cylinder Level Indicator/Solidworks/feet.SLDPRT

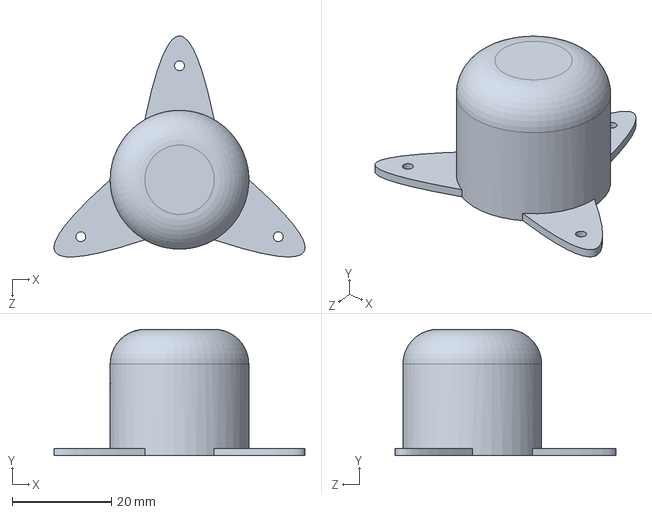
[picture p52: CAD file, 2023-03-15]
EN-17 Gas Cylinder Level Indicator/Solidworks/feet.SLDPRT
50.6 x 25.5 x 44.6 mm
