Anuki16/gas-level-indicator/EN-17 Gas Cylinder Level Indicator/Solidworks/bottom.SLDPRT

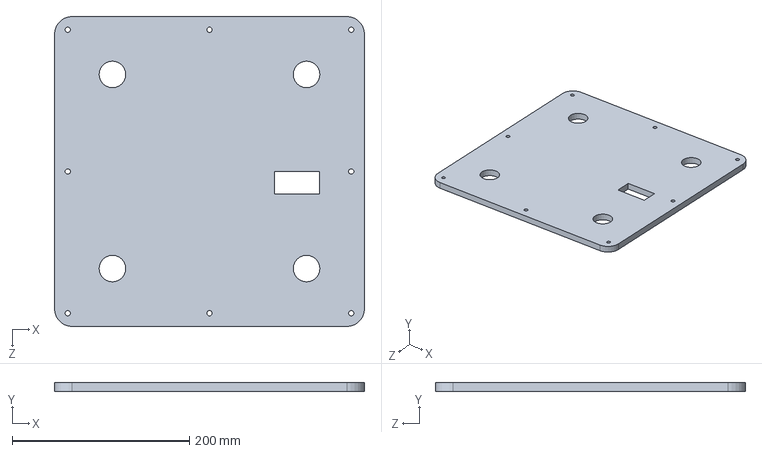
[picture p53: CAD file, 2023-03-15]
EN-17 Gas Cylinder Level Indicator/Solidworks/bottom.SLDPRT
350.0 x 10.0 x 350.0 mm
