Anuki16/gas-level-indicator/(list of files, drawings)

Other design files:
code/Arduino 328/Arduino 328.pdsprj
EN-17 Gas Cylinder Level Indicator/Altium/PCB1.PcbDoc
EN-17 Gas Cylinder Level Indicator/Altium/Sheet1.SchDoc
PCB design/Design_Project_PCB/Design_Project_PCB.PrjPcb
PCB design/layout.PcbDoc
PCB design/schematic.SchDoc
